qppd/smart-collar/README.md

# SmartCollar

**Offline GPS and LoRa-Based Smart Collar System for Carabao Location Monitoring and Tamper Detection**

A carabao wears a sealed, adjustable smart collar that acquires its GPS position and streams it over a LoRa radio link to a farm base station — **the collar itself needs no internet, no cellular signal, no subscriptions**. The base station checks every position against a geofence, watches for collar tampering and 24-hour immobility, and sounds a siren alarm on any abnormal condition. Farmers monitor locations and configure geofences from an **offline app installed on their phone**, connected to the base station over Bluetooth LE.

> Offline-first by design: positioning (GPS), collar communication (LoRa), and the farmer's app (Bluetooth LE + offline map data) never need the internet. The only time the project touches the internet is a **one-time provisioning step** — downloading the app bundle, MapLibre, and OpenStreetMap map data before deployment.

---

## Table of Contents

- [About](#about)
- [Main System](#main-system)
- [How It Works](#how-it-works)
- [Features & Alarm Conditions](#features--alarm-conditions)
- [System Architecture](#system-architecture)
- [Hardware](#hardware)
- [Design Priorities](#design-priorities)
- [Repository Structure](#repository-structure)
- [Build Guide](#build-guide)
- [Documentation Index](#documentation-index)
- [Power Strategy](#power-strategy)
- [Roadmap](#roadmap)
- [Team](#team)
- [Acknowledgment](#acknowledgment)

## About

Carabao theft, straying, and unmonitored sickness are real losses for smallholder farms — and rural grazing land usually has **no internet or cellular coverage**, which rules out commercial GSM/GPS trackers. SmartCollar is built for that reality: positioning comes from GPS satellites, communication travels over LoRa radio (kilometer-scale range, very low power), and all alarm logic runs locally at the base station. The whole system works even when the farm is completely offline.

The collar is worn by the animal full-time, so the **mechanical design is as critical as the electronics**: the collar is exposed to water (carabaos wallow and swim), mud, impact, pulling, and constant movement. Every design decision in this repo reflects that.

## Main System

| Component | Location | Role |
|---|---|---|
| **Smart Collar** | Worn by the carabao | GPS positioning, LoRa uplink, tamper detection, battery telemetry (discrete ESP32 build) |
| **Base Station** | Fixed, powered point at the farm | Receives LoRa data, evaluates alarm rules, drives the siren; pairs to the app over Bluetooth LE |
| **Offline Mobile/Desktop App** | Farmer's device | Location & status dashboard, geofence configuration |
| **Siren Alarm** | At the base station | Loud audible alert on any detected abnormal condition |

## How It Works

```mermaid
flowchart LR
    CAR["Carabao"] --> COLLAR["Smart Collar"]
    COLLAR -- "GPS + LoRa" --> BASE["Base Station"]
    BASE --> OUT["Siren + Offline App"]
```

1. The collar wakes on a duty cycle, gets a GPS fix, checks its tamper loop, and sends one compact LoRa packet (position, battery, tamper state, movement activity).
2. The base station receives the packet and evaluates three alarm rules:
   - **Geofence** — is the position inside the allowed polygon?
   - **Tamper** — strap cut, buckle opened, or loop bypassed?
   - **No movement for 24 hours** — possible downed or sick animal.
3. On any abnormal condition, the base station **fires the siren** and pushes an alert to the app.
4. The farmer opens the app on their phone (paired directly to the base station over Bluetooth LE, or USB on a laptop) to see live locations, history, status, and to **draw or edit the geofence**, which is pushed down to the collars.
5. The app renders the map from OpenStreetMap data pre-downloaded onto the phone (MapLibre, one-time provisioning) — no internet is needed at the farm, and an animal outside the geofence stays visible on the map as far as the collar can still report.

## Features & Alarm Conditions

The system raises an alarm when:

| # | Condition | What it means |
|---|---|---|
| 1 | **Geofence breach** | The carabao left the allowed grazing area |
| 2 | **Collar tamper** | Strap cut, buckle opened/removed, or tamper circuit bypass attempt |
| 3 | **No movement for 24 hours** | Abnormal condition — animal may be downed, trapped, or sick; needs physical checking |

Additional capabilities:

- Offline-first operation — GPS + LoRa + Bluetooth LE; no internet needed at the collar, base, or app
- Live location and history trail per collar, on an offline map in the app (OpenStreetMap + MapLibre, one-time provisioning)
- Geofence drawing/editing from the app, pushed to collars via the base station
- Battery level telemetry with low-battery warning
- Adjustable collar (fits different animals) **without** sacrificing tamper detection
- **Maintenance mode toggle** in the app — deliberate collar work (battery swap, strap adjustment) without triggering the siren; auto-expires so it can never silently mute the farm

## System Architecture

```mermaid
flowchart TB
    GPS["GPS satellites"] --> COLLAR["SMART COLLAR (on carabao)\nESP32 DevKit 38-pin + NEO-M8N GPS + SX1276 (915 MHz)\ntamper loop · MPU6050 · 18650"]
    LOOP["Tamper loop (wire rope)"] --> COLLAR
    COLLAR <-. "LoRa 915 MHz · offline radio link" .-> BASE["BASE STATION\nESP32 DevKit + SX1276 · alarm rules engine\ngeofence / tamper / 24 h no-move\nsiren driver · local app server"]
    BASE -- "relay" --> SIREN["SIREN ALARM<br/>12 V, loud"]
    BASE <-. "Bluetooth LE / USB — offline" .-> APP["OFFLINE APP (PWA)<br/>mobile / desktop<br/>MapLibre + offline OSM data<br/>map + geofence editor"]
```
Details: [docs/BLOCK-DIAGRAM.md](docs/BLOCK-DIAGRAM.md) · [docs/SYSTEM-ARCHITECTURE.md](docs/SYSTEM-ARCHITECTURE.md) · [docs/FLOWCHART.md](docs/FLOWCHART.md) · [docs/STACK.md](docs/STACK.md)

## Hardware

Core components (full list with indicative prices: **[docs/BOM.md](docs/BOM.md)**):

| Component | Role |
|---|---|
| ESP32 DevKit 38-pin + NEO-M8N GPS + SX1276 LoRa | Collar core — discrete ESP32 board with external GPS and LoRa modules (replaces integrated T-Beam) |
| 18650 Li-ion cell + holder | Collar power (Phase 1) — PMU-protected, charged off-animal in a smart charger |
| Conductive tamper loop (stainless wire rope) with buckle break-away link | Tamper detection on the adjustable strap |
| IP67 enclosure + PG7 glands + Suxun T7000 silicone sealant | Waterproof housing (carabaos wallow in water/mud) |
| Flexible whip antenna (915 MHz) | LoRa uplink, bulkhead-mounted, strain-relieved |
| MPU6050 accelerometer (GY-521) | Movement activity for the 24-hour no-movement rule |
| ESP32 DevKit + SX1276 LoRa module | Base station receiver |
| 12V waterproof siren + relay/MOSFET | Audible alarm at the base station |
| 2–3× 5 V 0.3 W solar panels (parallel) + CN3065 charge module | Phase 2 solar upgrade — farm-recommended |

## Design Priorities

The current design focus, in order of difficulty — each has a dedicated document:

| Priority | Document | Summary |
|---|---|---|
| Adjustable collar + reliable tamper circuit | [TAMPER.md](docs/TAMPER.md) | A continuous conductive loop across the **adjustable** portion — detects cut, buckle open, and bypass |
| Waterproof enclosure | [ENCLOSURE.md](docs/ENCLOSURE.md) | Sealed against wallowing/submersion, impact-resistant, protects electronics |
| Antenna strategy | [ENCLOSURE.md](docs/ENCLOSURE.md) | External antenna vs. sealed performance — must not degrade LoRa/GPS |
| Battery management | [POWER.md](docs/POWER.md) | Duty-cycled operation for weeks per charge |
| Solar-ready mechanical design | [ENCLOSURE.md](docs/ENCLOSURE.md) + [POWER.md](docs/POWER.md) | Farm recommends solar collars (video in `references/`); enclosure is solar-ready from day one — 2–3× 0.3 W panels on the lid |
| Physical form factor | [ENCLOSURE.md](docs/ENCLOSURE.md) | Based on the farm's recommendation and sample collar |

> **Key point:** this is not just a software/electronics project. The **mechanical design of the collar itself is critical** — it is exposed to water, mud, impact, pulling, and constant movement for its entire service life.

## Repository Structure

```
smartcollar/
├── README.md               ← you are here
├── docs/
│   ├── BOM.md              ← parts list with indicative prices
│   ├── WIRING.md           ← circuit diagram + full netlist (collar & base)
│   ├── HARDWARE.md         ← collar electronics, wiring, assembly
│   ├── TAMPER.md           ← tamper loop design on the adjustable collar
│   ├── ENCLOSURE.md        ← waterproofing, mechanical, antenna, solar-ready design
│   ├── POWER.md            ← battery management + solar roadmap
│   ├── FIRMWARE.md         ← collar & base station firmware, LoRa protocol
│   ├── BASE-STATION.md     ← receiver, siren, coverage planning
│   ├── MAP-PACK.md         ← one-time offline map provisioning guide
│   ├── APP.md              ← offline dashboard, geofence editor
│   ├── TESTING.md          ← test & evaluation protocol
│   ├── STACK.md            ← full technology stack reference
│   ├── BLOCK-DIAGRAM.md    ← hardware blocks & signal chains
│   ├── FLOWCHART.md        ← runtime decision logic
│   ├── SYSTEM-ARCHITECTURE.md ← layers, interfaces, failure modes
│   └── NTC-COMPLIANCE.md   ← PH radio regulations & certification guidance
├── model/
│   └── SmartCollar.f3z  ← Fusion 360 3D model
├── wiring/
│   ├── SmartCollar.png     ← full wiring diagram (Cirkit Designer)
│   └── SmartCollar.ckt     ← editable Cirkit Designer project
└── references/             ← datasheets, farm video, related material
```

## Build Guide

The build is organized into stages. Follow in order:

| Step | Guide | What you'll do |
|---:|---|---|
| 1 | [docs/BOM.md](docs/BOM.md) | Order all parts |
| 2 | [docs/WIRING.md](docs/WIRING.md) | Study the circuit diagram + netlist (collar & base) |
|| 3 | [docs/HARDWARE.md](docs/HARDWARE.md) | Assemble collar electronics, verify ESP32 GPS + LoRa |
| 4 | [docs/TAMPER.md](docs/TAMPER.md) | Build and validate the adjustable tamper loop |
| 5 | [docs/ENCLOSURE.md](docs/ENCLOSURE.md) | Seal the enclosure, mount antenna, solar-ready lid |
| 6 | [docs/POWER.md](docs/POWER.md) | Configure duty cycling, measure battery endurance |
| 7 | [docs/FIRMWARE.md](docs/FIRMWARE.md) | Flash collar + base station, tune the LoRa protocol |
| 8 | [docs/BASE-STATION.md](docs/BASE-STATION.md) | Install receiver, siren, coverage survey |
| 9 | [docs/MAP-PACK.md](docs/MAP-PACK.md) | Build the offline Map Pack (MapLibre + OpenStreetMap) |
| 10 | [docs/APP.md](docs/APP.md) | Set up the offline dashboard + geofence editor |
| 11 | [docs/TESTING.md](docs/TESTING.md) | Run the full verification protocol |

## Documentation Index

| Document | Contents |
|---|---|
| [BOM.md](docs/BOM.md) | Collar + base station parts, specs, indicative PH prices |
| [WIRING.md](docs/WIRING.md) | Circuit diagram, full netlist, power rails, build-order notes |
|| [HARDWARE.md](docs/HARDWARE.md) | Collar electronics, wiring tables, accelerometer, assembly (discrete ESP32 build) |
| [TAMPER.md](docs/TAMPER.md) | Tamper loop options, supervised-loop circuit, bypass resistance, alarm codes |
| [ENCLOSURE.md](docs/ENCLOSURE.md) | IP-rating targets, sealing strategy, antenna mounting, solar-ready design, mechanical tests |
| [POWER.md](docs/POWER.md) | Power budget, duty cycle, charging rotation, solar sizing |
| [FIRMWARE.md](docs/FIRMWARE.md) | State machines, LoRa packet format, geofence & alarm logic |
| [BASE-STATION.md](docs/BASE-STATION.md) | Hardware, antenna placement, siren wiring, range planning |
| [MAP-PACK.md](docs/MAP-PACK.md) | One-time provisioning: MapLibre + OSM extract for the offline map |
| [APP.md](docs/APP.md) | Offline maps, dashboard, geofence editor, tech options |
| [TESTING.md](docs/TESTING.md) | Range, GPS, tamper, immersion, endurance, mechanical tests |
| [STACK.md](docs/STACK.md) | Full technology stack — collar, base station, app, radio link |
| [BLOCK-DIAGRAM.md](docs/BLOCK-DIAGRAM.md) | Hardware blocks, tamper sense circuit, signal chains |
| [FLOWCHART.md](docs/FLOWCHART.md) | Runtime logic — collar duty cycle, base alarm pipeline, app session |
| [SYSTEM-ARCHITECTURE.md](docs/SYSTEM-ARCHITECTURE.md) | Layers, component responsibilities, interfaces, failure modes |

## Power Strategy

- **Phase 1:** battery-powered collars — 18650 Li-ion, aggressive duty cycling, ~2 weeks per charge with swap rotation.
- **Phase 2:** solar lid-swap upgrade — enclosure solar-ready from day one. Full details: [POWER.md](docs/POWER.md).

## Roadmap

- [x] Circuit diagram + netlist drawn (Cirkit Designer — [WIRING.md](docs/WIRING.md))
- [ ] Parts ordered & verified (BOM)
|- [ ] Discrete ESP32 collar bench test: GPS fix + LoRa link
- [ ] Tamper loop working on an adjustable strap
- [ ] Enclosure passes immersion test
- [ ] Full collar worn-test on animal (comfort, anti-rotation, wallow test)
- [ ] Base station + siren installed at farm
- [ ] Offline app with geofence editor
- [ ] Field trial: multi-day herd monitoring
- [ ] Solar lid prototype (Phase 2)

## Team

`[Course / Program]` · `[University]`

- `[Student Name]`
- `[Student Name]`
- `[Student Name]`

Adviser: `[Adviser Name]`

## Acknowledgment

Pilot client: **[Farm name]** — who recommended the solar collar direction and provided a sample collar video (kept in `references/`).

| *This project is an academic prototype. The full manuscript is available from the team on request.*

---

## Hardware Migration Note (2026-11)

The original design used a LilyGO T-Beam v2.x integrated board. For improved sourcing reliability and modularity in the Philippines, the project has been migrated to a **discrete ESP32 DevKit 38-pin** build with separate NEO-M8N GPS and SX1276 LoRa modules.

All original objectives, features, and functionality are preserved. The migration details are documented inline in each guide: [HARDWARE.md](docs/HARDWARE.md) for pin maps and power architecture, [BOM.md](docs/BOM.md) for sourcing, [NTC-COMPLIANCE.md](docs/NTC-COMPLIANCE.md) for regulatory guidance.
