qppd/smart-collar/references/README.md

# References

Source materials for the SmartCollar project.

| File | What it is |
|---|---|
| `farm-solar-collar-sample.mp4` *(to be added)* | Video sent by the farm — sample collar with solar panel. Basis of the solar-ready enclosure requirement and Phase-2 roadmap ([POWER.md](../docs/POWER.md), [ENCLOSURE.md](../docs/ENCLOSURE.md)). Save the original file here. |
| `tbeam-v2.x-datasheet.pdf` *(to be added)* | LilyGO T-Beam v2.x specifications (ESP32, NEO-M8N, SX1278, AXP2101 PMU). |
| `sx1278-datasheet.pdf` *(to be added)* | Semtech SX1278 LoRa transceiver datasheet (the SX1276/77/78 family datasheet) — radio settings, sleep currents, link budget. |
| `mpu6050-datasheet.pdf` *(to be added)* | InvenSense MPU6050 — motion-detect (MOT_THR/MOT_DUR) + accel-only cycle mode configuration for the 24-h rule. |

## To Collect

- [ ] Farm's sample-collar video → save as `farm-solar-collar-sample.mp4`
- [ ] Datasheets above (download PDFs into this folder)
- [ ] Photos of the farm site (site survey, mast candidates)
- [ ] PH frequency-regulation notes for 433/915 MHz ISM use (NTC)
- [ ] Commercial GPS tracker specs for comparison table (capstone Related Works)
