qppd/smart-collar/docs/SYSTEM-ARCHITECTURE.md

# System Architecture

Layers, boundaries, and interfaces — how SmartCollar is organized as a system, from strap to siren. Diagrams are **Mermaid** and render in any Mermaid-compatible viewer.

---

## 1. Layered View

```mermaid
flowchart TB
    L5["L5 · PRESENTATION<br/>PWA (MapLibre + offline OSM data)<br/>map · alarm feed · geofence editor · maintenance toggle"]
    L4["L4 · APPLICATION (base)<br/>BLE GATT server + USB serial · config endpoints<br/>siren driver · ACK/re-arm handling<br/>maintenance-mode gate"]
    L3["L3 · RULES &amp; DATA (base)<br/>alarm engine: geofence / tamper / 24 h no-move<br/>ring buffer + LittleFS history (CSV/JSON)"]
    L2["L2 · EDGE DEVICES<br/>collar firmware: duty-cycle state machine, GPS,<br/>tamper sense, activity counter, LoRa MAC<br/>base firmware: RX, dedupe, rules feed"]
    L1["L1 · SENSING &amp; PHYSICS<br/>NEO-M8N GPS · supervised tamper loop · MPU6050<br/>SX1276 LoRa radios (915 MHz) · 18650 + AP2112 LDO + GPIO-gated rails"]
    L1 -- "GPIO electrical" --> L2
    L2 -- "LoRa 915 MHz radio" --> L3
    L3 --- L4
    L4 -- "Bluetooth LE / USB (offline)" --> L5
```

**Key boundary decisions:**

- **Collar senses, base decides.** The collar's job is a compact, honest packet: position, battery, tamper flags, activity. All alarm logic — geofence, tamper verdict, 24-hour immobility — runs at the base, where power and compute are unlimited. Collars stay dumb, cheap, and low-power.
- **Raw LoRa, not LoRaWAN.** There is no offline gateway/network-server infrastructure, and we control both ends. A simple ACK/retry MAC with jittered intervals replaces it entirely.
- **The base *is* the farm's local server.** App data, config, history, alarms — all served from one ESP32 over **Bluetooth LE** or USB; the map stack (MapLibre + OpenStreetMap data) lives in each phone from one-time provisioning. The farmer's phone never needs a network beyond the farm.
- **The app talks to the base over Bluetooth LE, never the internet.** The phone pairs to the base's GATT server (notify + write characteristics); map data comes from the phone's one-time OSM/MapLibre provisioning. The collar stays offline by design — LoRa is its only radio. The core loop (LoRa → rules → siren → local app) has no cloud dependency anywhere.
- **Collar evaluation is early-warning only.** The collar can hold the geofence polygon and flag "outside" on-carpet, but the base's point-in-polygon verdict is authoritative.

## 2. Component Responsibilities

| Component | Owns | Never does |
|---|---|---|
| NEO-M8N GPS | position fixes (warm-start ephemeris in RTC RAM) | alarm decisions |
| Supervised tamper loop | resistance signature of the intact collar (baseline R₀, recorded per collar) | power switching |
| MPU6050 | motion activity + motion-detect interrupt | position (GPS's job) |
| Collar ESP32 | duty cycle, tamper ADC, packet build/TX, latch handling | point-in-polygon verdicts (early flag only) |
| Base ESP32 | RX/dedupe, alarm rules, siren patterns, app server, history | GPS fixes |
| LittleFS history | durable per-collar log (position, flags, loop R, batt) | alarm logic |
| Siren | audible alert, patterned per alarm type | logic |
| PWA | map, alarm feed, ACK, geofence drawing | rule evaluation (base's job) |

## 3. Interfaces (the contract set)

| # | Interface | Protocol | Contract |
|---|---|---|---|
| I1 | GPS → collar UART | NMEA (TinyGPSPlus) | fix within 90 s or STALE reuse |
| I2 | Tamper loop → GPIO36 | analog ADC via 10 kΩ bias, GPIO25 excite | bands relative to baseline R₀; outside = latched alarm |
| I3 | MPU6050 → collar I²C | I²C poll each wake (21/22) | latched motion flag → activity counter; never a GPS/TX cycle |
| I4 | Collar → base (SX1276 → Ra-02 SX1276) | raw LoRa 915 MHz, SF7–SF9, sync 0x2B, ≤23 B binary | position, battery, tamper flags, activity, SEQ |
| I5 | Base → collar downlink | LoRa at wake windows / daily sync | geofence polygon, interval change, ACK, clear-tamper-latch |
| I6 | Base ↔ phone | Bluetooth LE GATT (Web Bluetooth): notify + write | live positions/alarms (MTU-chunked JSON); commands: geofence, ACK, interval, MAINT_ON/OFF |
| I7 | Base ↔ USB device | Web Serial (Chrome) | most-reliable zero-WiFi channel |
| I8 | Base → siren | GPIO17 → relay IN1 → 12 V | patterned drive per alarm type (GPIO23 reserved for Ra-02 SPI MOSI) |
| I9 | Phone → base clock sync | BLE `TIME_SET {epoch}` on app connect | wall-clock timestamps; `unsynced` flag after an offline reboot — no alarm rule depends on wall time |
| I10 | Maintenance toggle → rules engine | BLE `MAINT_ON {min}` / `MAINT_OFF` | gates siren/alarm path only; detected events logged as `suppressed`; auto-expires |

## 4. Network Topology

```mermaid
flowchart LR
    C1["Collar #1"] <-. "LoRa 915 MHz<br/>jittered intervals" .-> BASE["BASE STATION<br/>mast antenna 3–5 m, grounded<br/>phone-set clock · BLE server"]
    C2["Collar #2"] <-.-> BASE
    CN["Collar #N"] <-.-> BASE
    BASE -- "Bluetooth LE GATT<br/>notify + write" --> PHONE["Farmer phone<br/>PWA installed to home screen"]
    BASE -- "USB (serial)" --> LAPTOP["Laptop / desktop"]
    BASE -- "relay" --> SIREN["12 V siren"]
```

- **One star topology:** all collars → one base; nothing meshed, nothing routed. A dead collar can't take others down.
- **Frequency plan:** 915 MHz ISM preferred in PH; collar and base bands **must match**.
- **Range reality:** 2–8 km open/rolling terrain, 300 m–2 km dense trees (SF7–SF9 choice per site) — the site survey decides placement, not hope.
- **No SIM, no WiFi anywhere:** the collar's only external dependency is GPS satellites; the only farm infrastructure link is Bluetooth LE to the farmer's phone. The internet appears exactly once — downloading MapLibre + OpenStreetMap data during provisioning.

## 5. Failure Modes & Degradation

| Failure | Immediate effect | System behavior |
|---|---|---|
| GPS no-fix (canopy, rain) | position STALE | reuse last fix, flag it; alarm rules keep running on stale data |
| LoRa packet lost | missed position | SEQ dedupe on RX; emergency packets retry 3× @ 30 s; buffer at next wake |
| Collar battery low | shorter radio life | BAT_PERCENT telemetry → app alert < 20%; swap-and-charge rotation |
| Base brownout | rules pause | no UPS by design — history in LittleFS survives; watchdog self-heals; clock re-syncs from the phone on next connect; collars buffer-and-retry until power returns |
| Lightning storm | antenna risk | disconnect procedure; collars buffer-and-retry — an offline hour is fine |
| Tamper false positives (corrosion) | spurious alarms | 8-sample ADC averaging, window margins, debounce; app maintenance mode = service window |
| Farmer misses alarm | siren keeps sounding | re-arm logic: ACK silences siren but event persists until condition clears (e.g., 2 packets back inside fence) |
| App phone offline | no dashboard | cached PWA opens offline; history catches up over BLE (delta-sync) on reconnect |
| Phone out of BLE range | no live dashboard | the farm doesn't stop — LoRa RX, rules, siren, and history all run headless; the app catches up over BLE (delta-sync) on reconnect |
| Maintenance toggle left ON | alarms muted | **auto-expiry** (default 30 min, max 2 h) re-enables the siren; every ON/OFF/expiry is timestamped |

**Design principle:** every abnormal condition is *latched* — a transient (brief loop open, one lost packet) can never silently clear itself without the base seeing it.

## 6. Deployment Topology (prototype → production path)

```mermaid
flowchart LR
    P1["Phase 1 · Prototype<br/>battery collars (18650)<br/>swap-and-charge rotation<br/>~2 weeks per charge"] --> P2["Phase 2 · Solar lid<br/>5 V panel + Li charge module<br/>lid swap — no redesign<br/>(enclosure solar-ready from day 1)"]
```

The architecture doesn't change between phases — only the collar's power source (and the enclosure lid). Base, radio, rules, and app are identical.

---

Interfaces in detail: [FIRMWARE.md](FIRMWARE.md) §packet format · Alarm rules: [BASE-STATION.md](BASE-STATION.md) · Signals: [BLOCK-DIAGRAM.md](BLOCK-DIAGRAM.md) · Logic: [FLOWCHART.md](FLOWCHART.md)
