qppd/smart-collar/docs/POWER.md

# Power Strategy — Battery Now, Solar-Ready

Two-phase strategy, driven by the farm's own recommendation:

- **Phase 1 (prototype, this repo):** battery-powered — 18650 Li-ion, aggressive duty cycling, swap-and-charge rotation.
- **Phase 2 (upgrade):** solar trickle charging — small panel on a swappable lid. **The Phase-1 enclosure and electrical layout are already solar-ready** (see [ENCLOSURE.md](ENCLOSURE.md)) so the upgrade is a lid swap, not a redesign.

---

## Phase 1 — Battery Budget (per collar)

Assume an **ESP32 DevKit 38-pin** + **NEO-M8N GPS** + **SX1278-class LoRa (433 MHz)** on one 18650 (3,500 mAh, ~11.5 Wh). No integrated PMU — rail shutdown via GPIO-gated N-channel MOSFETs.

### Component current draw (order-of-magnitude, datasheet-typical)

| State | Subsystems on | Current | Duration per cycle |
|---|---|---:|---|
| GPS fix acquisition | ESP32 active + GPS module | ~90 mA | 30–60 s (TTFF from cold; warm fix ~5–15 s) |
| LoRa TX (1 packet, SF7–SF9) | ESP32 active + radio | ~120 mA | 0.1–0.3 s |
| Accelerometer watch (movement rule) | MPU6050 in accel-only cycle mode | ~10–70 µA | continuous while sleeping |
| Deep sleep between cycles | ESP32 deep sleep + RTC + MPULDO off | **~0.5–2 mA\*** | rest of interval |

\* With GPIO-gated rail cutoff (GPS/LoRa rails off), ESP32 deep-sleep base is ~10 mA but only RTC runs (~0.1 mA). With GPS and LoRa modules powered down via MOSFETs, total system sleep approaches **~0.5–1.5 mA**. Measure real current early.

### Duty cycle scenarios (10-min reporting interval, 1-min GPS window)

Average current ≈ (GPS 60 s × 90 mA + TX 0.3 s × 120 mA + RX window 3 s × 90 mA + sleep 536.7 s × 1.5 mA) / 600 s ≈ **~10.95 mA**

| Reporting interval | Est. average current | Runtime on 3,500 mAh |
|---|---:|---|
| 5 min | ~19.5 mA | ~7 days |
| **10 min (chosen)** | ~11.0 mA | **~13 days** |
| 15 min | ~7.9 mA | ~18 days |
| 30 min | ~4.8 mA | ~30 days |

> **Worst-case note:** the budget above assumes a **60 s GPS fix per cycle** (warm start) plus a 3 s RX window after every TX (see [FIRMWARE.md](FIRMWARE.md) — RX windows). If cold fixes run to the firmware's `GPS_TIMEOUT` of 90 s (see [FIRMWARE.md](FIRMWARE.md)) every cycle, average current rises to **~15.2 mA → ~10 days** on 3,500 mAh. `moved=false` motion-gating and warm-start ephemeris exist precisely to keep real-world duty below this line; measure actual fix duration during bench bring-up.

**Design target: ≥ 2 weeks per charge at a 10-minute interval**, with a swap rotation (one charged spare per collar) so animals are never un-collared. The interval is configurable from the app per collar — racehorses get 5 min, calm herds 30 min.

> GPS duty-cycling dominates the budget. Two easy wins: (1) **warm starts** — keep GPS ephemeris in RAM (fix in 5–15 s instead of 30–60 s); (2) **motion-gated fixes** — if the accelerometer says the animal hasn't moved since the last fix, skip GPS and re-send the last known position (movement ≤ threshold), saving up to ~80% of GPS energy.

### The 24-hour no-movement rule and power

The accelerometer must run *while the collar sleeps* — use the **MPU6050 motion-detect interrupt**: accel-only cycle mode (register PWR_MGMT_1 = accel on, gyro + temp off; LP_WAKE_CTRL rate 5 Hz) detects activity at ~10–70 µA and wakes the ESP32 only on movement (MOT_THR / MOT_DUR configured for head-shake / grazing-scale motion, not vibration noise).

**Critical power rule:** motion is **polled, never an interrupt** — each 10-min wake reads the MPU6050's latched motion flag (INT_STATUS), increments the activity counter if set, and goes straight back to sleep. Motion **never** triggers a full GPS/TX cycle (an actively grazing carabao would destroy the budget). Full cycles run on the RTC timer only. If the counter hasn't incremented in 24 h, the next scheduled LoRa packet is flagged `NO_MOVEMENT` → base station raises the alarm.

**GY-521 module caution (sleeper current):** the common purple GY-521 breakout has a power LED (~1–2 mA) and an LDO (~1 mA quiescent) that never sleep — 2–3 mA that would dominate the whole sleep budget. Fix at assembly: **strip the power LED** and **bypass the LDO** (feed 3V3 straight to VCC), or budget for it. Bare-die MPU6050 on a custom board avoids this entirely. Verify with the µA meter — same rule as the discrete build rails.

### Measured-first policy

All figures above are estimates. In Week 1, measure for real (see [TESTING.md](TESTING.md)):

1. Actual deep-sleep current of the ESP32 build (USB power meter + inline ammeter; expect surprises)
2. Actual TTFF warm vs cold at the farm (open sky)
3. Actual energy per GPS+TX cycle

Then finalize the reporting interval that gives ≥ 2 weeks.

## Battery Care & Safety

- **Protection story:** the sourced LiitoKala cells are an unprotected 10 A high-drain class (protected-cell listings didn't qualify — see [BOM.md](BOM.md)). The TP4056 charging module provides over-voltage/over-current cut-off during USB charging; all main charging happens off-animal in the smart charger (below), never on-animal, never unattended.
- Low-battery alarm at 20% (app notification), critical at 10% (collar reduces interval to conserve, still must alarm).
- Charge at ≤ 0.5 C on the LiitoKala Lii-500 smart charger (4-slot, capacity-test mode — its test figure drives the cell-retirement log); rotate cells FIFO; retire cells at < 80% rated capacity (log per cell ID in the app maintenance record).
- Temperature: Li-ion must never charge below 0 °C or above 45 °C — carabao collar interior can exceed this in direct sun; the charger must be temperature-compensated or charging happens indoors during the swap (Phase 1: **charging happens off-animal, indoors** — simplest and safest).
- Cell holder with tabs soldered (not spring contacts if vibration is severe — springs walk off; crimped tab + holder hybrid chosen).

## Phase 2 — Solar Sizing

Sizing logic (10-min interval, ~10.95 mA avg @ 3.7 V ≈ **~41 mW** continuous — includes the 3 s RX window after every TX):

| Requirement | Value |
|---|---:|
| Daily energy need | ~0.97 Wh |
| PH sun (conservative effective) | 3 h/day full-sun equivalent |
| Array needed (with 70% path efficiency incl. shading/dirt/charge loss) | ~0.62 W STC → **2–3× 5 V 0.3 W panels** |

**Panel choice: sourced 5 V 0.3 W epoxy panels (Lazada, ~₱93 each — see [BOM.md](BOM.md)), all the same voltage class, wired in parallel.** Physics check: 2 × 0.3 W STC × 3 h × 70% ≈ **1.26 Wh/day**, already above the need — see the array table below.

| Array (parallel) | STC power | Harvest/day (3 h, 70%) | Coverage of 0.97 Wh |
|---|---:|---:|---|
| 1× 0.3 W panel | 0.3 W | ~0.63 Wh | ~65% — roughly triples the swap interval |
| 2× 0.3 W panels | 0.6 W | ~1.26 Wh | **~130% — break-even at 10-min interval** |
| 3× 0.3 W panels | 0.9 W | ~1.89 Wh | ~195% — headroom for rainy days & motion-gated skips |

At a 30-min reporting interval the need drops to ~0.43 Wh/day → **one panel breaks even** there. **Sourced panels are 5 V 0.3 W epoxy units (~₱93 each, see [BOM.md](BOM.md))** — the exact 20×20 mm / 0.04–0.06 W class isn't listed on Lazada PH, so **2–3 sourced panels replace the originally sketched 6–8× 2×2 cm array**. Target stays: battery as buffer, solar as trickle — the collar rides through nights and rainy days on the 18650, and the array tops it up during grazing. Rainy-season expectations: solar extends the swap interval from 2 weeks toward 1–2 months rather than making it infinite.

### Wiring (validated against CN3065 + ESP32 build)

Chain: **array → per-panel Schottky → potted junction → PG7 gland → sealed JST 2-pin → CN3065 VIN; CN3065 BAT → 18650 tabs (in parallel with the ESP32 battery connection)**. The ESP32 draws from the cell directly via the AP2112 LDO; the CN3065 charges the cell independently (USB charger stays for bench charging).

1. **Parallel only, never series.** Series stacking pushes input past the CN3065's 6.5 V absolute maximum (operating range 4.4–6.0 V). Parallel adds current only — exactly what a trickle array wants.
2. **One Schottky diode (1N5819/SS14) in series with each panel.** Without it, a shaded panel *sinks* current from the lit ones — the animal's head shadow is the common case, not an edge case. Diodes cost ~₱2 each and cut shading loss to roughly the shaded fraction.
3. **Voltage class:** prefer 5 V-class panels (Voc ~6.0–6.3 V); 5.5 V-class (Voc 6.6 V) rides close to the CN3065's 6.5 V abs-max on a cold bright morning. In PH heat the real Voc sits well under the STC figure (−0.33 %/°C), so both classes work — but verify with a multimeter at build time (checklist below).
4. **Charge rate is inherently safe.** ~80–160 mA from the array into a 3,500 mAh cell = **0.02–0.05 C trickle** — thermally gentle even when the enclosure interior warms past ambient (Li-ion charge window 0–45 °C; PH never approaches 0 °C). The Phase-1 rule "0.5 C charging happens indoors" stays for USB smart-charger swaps.
5. **TS/TEMP pin grounded** (stock module default) — no NTC on tab-soldered 18650s; the low trickle rate is the safety margin instead.
6. **Night drain:** the CN3065 sleeps at < 3 µA with no input (datasheet) — negligible against the 1.5 mA deep-sleep budget.
7. **Telemetry unaffected:** battery percentage comes from ADC reading (GPIO35) through a resistive divider — truthful with solar in parallel.
8. **Feed the cell, not the ESP32 USB/5V pin.** The CN3065 charges the cell directly; the ESP32 draws from the cell through the AP2112 LDO. This is why a solar charge module is required, not just a diode.

## Solar Roadmap Checklist

- [ ] Verify Phase-1 enclosure accepts the solar lid with no case redesign
- [ ] Measure each 0.3 W panel's Voc before wiring (must be ≤ 6.5 V class — 5 V-class preferred; identical voltage class across all panels)
- [ ] Bench-test CN3065 + 0.3 W panel array → 18650 charge profile in sun/window light
- [ ] Partial shading test (animal's head blocks half the panel) — charge current still positive?
- [ ] Lid gasket survives 50 lid-swaps (service simulation)
- [ ] 2-week field trial on one animal → log battery % vs sun exposure
