qppd/smart-collar/docs/FLOWCHART.md

# Flowchart

Runtime behavior, decision by decision — the logic view of SmartCollar, matching the actual firmware state machines in FIRMWARE.md. Diagrams are **Mermaid** and render in any Mermaid-compatible viewer.

---

## 1. Collar Main State Machine

One duty cycle, every `REPORT_INTERVAL` (default 10 min) — motion is **polled each wake and only counts activity, never triggers a full cycle** (see POWER.md):

```mermaid
flowchart TB
    | DEEP SLEEP<br/>GPS rail off · LoRa rail off · AXP rails down (GPIO-gated) · wake on RTC timer only · target < 2 mA whole-system (measure!) |
    SLEEP -- "every 10 min (RTC timer)" --> WAKE["Wake · poll MPU6050 motion flag<br/>(latched INT_STATUS since last wake)"]
    WAKE -- "flag set" --> COUNT["activity counter++"]
    COUNT --> TAMPER
    WAKE --> TAMPER["Measure tamper loop<br/>GPIO25 excite → GPIO36 ADC<br/>8-sample avg · 100 ms debounce<br/>band check vs R₀ ± 30%?"]
    TAMPER --> GFIX{"GPS fix<br/>≤ 90 s?<br/>(warm-start RTC RAM)"}
    GFIX -- "no fix" --> STALE["reuse last position<br/>flag STALE"]
    GFIX -- "fix" --> POS["fresh position"]
    STALE --> PKT
    POS --> PKT["Build LoRa packet ≤ 23 B<br/>position · battery · tamper flags · activity · SEQ"]
    PKT --> TX{"TX OK?<br/>retries 3×"}
    TX -- "no ACK" --> RETRY["retry @ 30 s spacing<br/>(emergency packets)"]
    RETRY --> LATCHQ
    TX -- "sent" --> RXW["RX window 3 s<br/>ACK · interval · geofence chunks"]
    RXW --> LATCHQ{"Latched<br/>tamper alarm?"}
    LATCHQ -- "yes" --> NOW["send high-priority packet NOW<br/>then every 1 min until base ACKs<br/>(a collar under attack must not go quiet)"]
    NOW --> BACK
    LATCHQ -- "no" --> BACK["Deep sleep"]
    RETRY -- "still failing" --> BACK
    TAMPER -- "brief glitch, re-closed →" --> SUSPECT["latch LOOP_SUSPECT warning<br/>(telemetry only — no siren)"]
    SUSPECT --> GFIX
    TAMPER -- "outside window, debounced →" --> LATCHEV["latch alarm flag<br/>subtype CUT / SHORT preserved"]
    LATCHEV --> GFIX
```

## 2. Base Station Alarm Pipeline

Every received packet walks the rules engine:

```mermaid
flowchart TB
    RX["LoRa RX interrupt"] --> VAL{"validate MAGIC<br/>+ SEQ dedupe?"}
    VAL -- "invalid / replay" --> DROP["drop (no duplicate alarms)"]
    VAL -- "valid" --> RING["store in ring buffer<br/>(last N positions per collar)"]
    RING --> RULES["evaluate alarm rules"]
    RULES --> GEOF{"GEOFENCE:<br/>point-in-polygon on<br/>latest position?"}
    RULES --> TAMP{"TAMPER:<br/>FLAGS bits from collar?"}
    RULES --> NOMOVE{"NO_MOVE:<br/>ACTIVITY below threshold<br/>continuously 24 h?"}
    RULES --> BATT{"BAT_PERCENT<br/>&lt; 20%?"}
    BATT -- "yes" --> APPLERT["app alert only<br/>(no siren)"]
    BATT -- "no" --> HIST
    GEOF -- "breach" --> MAINT{"maintenance mode ON?<br/>(auto-expires)"}
    TAMP -- "yes" --> MAINT
    NOMOVE -- "yes" --> MAINT
    MAINT -- "yes" --> SUPPRESS["log as `suppressed`<br/>no siren · no alarm feed<br/>(battery/silence alerts still pass)"]
    SUPPRESS --> HIST
    MAINT -- "no" --> ALARM["NEW alarm → siren ON<br/>pattern per type · app push queued"]
    ALARM --> ACKQ{"farmer ACK in app?"}
    ACKQ -- "yes" --> SIRENOFF["siren OFF · event archived<br/>re-arm when condition clears<br/>(e.g. 2 consecutive packets back inside fence)"]
    GEOF -- "inside" --> HIST
    TAMP -- "no" --> HIST
    NOMOVE -- "no" --> HIST
    HIST["append history<br/>LittleFS CSV/JSON per collar<br/>~100 KB / collar / month<br/>clock: phone-set via BLE (TIME_SET)<br/>unsynced flag after offline reboot"]
    HIST --> PUSH["BLE notify → app<br/>(live positions + alarms,<br/>MTU-chunked JSON)"]
    PUSH --> WDOGB["task watchdog feeds<br/>(LoRa RX + BLE server loops)"]
    SIRENOFF --> WDOGB
    APPLERT --> HIST
```

**Siren patterns:** geofence = 3 short / 2-min pause repeat · tamper = continuous · no-movement = 10 s every 5 min. Auto re-arm.

## 3. App Session (farmer)

```mermaid
flowchart LR
    CONN["pair Bluetooth LE<br/>SmartCollar-Base<br/>(or USB serial)"] --> OPEN["open PWA<br/>fully offline<br/>(home-screen install)"]
    OPEN --> MAP["map view — MapLibre<br/>offline OpenStreetMap data<br/>live positions + history trail<br/>markers stay visible past the geofence"]
    MAP --> ALARMS["alarm feed + banner<br/>on-device notification (persistent)"]
    ALARMS --> ACK["ACK an alarm<br/>→ siren silences, event archived"]
    MAP --> EDIT["geofence editor<br/>draw/edit polygon, ≤ 16 vertices/paddock"]
    EDIT --> PUSH["save → BLE write → base pushes polygon<br/>to collars at next wake window"]
    PUSH --> MAP
    OPEN --> MAINT["Maintenance mode toggle<br/>MAINT_ON {minutes} / MAINT_OFF<br/>auto-expires · every change logged"]
    MAINT --> MAP
```

## 4. Geofence Push-Down Path

```mermaid
flowchart LR
    DRAW["farmer draws polygon<br/>in app"] --> SAVE["save over BLE write<br/>to base station"]
    SAVE --> DAILY["base broadcasts<br/>daily timeslot sync"]
    DAILY --> WINDOW["collars align wake<br/>windows to the sync"]
    WINDOW --> DL["downlink at wake:<br/>geofence polygon · interval change ·<br/>ACK · clear-tamper-latch (service mode)"]
    DL --> EARLY["collar evaluates polygon on-collar<br/>for early warning (geofence early flag)"]
```

---

State machine source: [FIRMWARE.md](FIRMWARE.md) · alarm rules & hysteresis: [BASE-STATION.md](BASE-STATION.md) · Blocks & signals: [BLOCK-DIAGRAM.md](BLOCK-DIAGRAM.md) · Layers: [SYSTEM-ARCHITECTURE.md](SYSTEM-ARCHITECTURE.md)
