qppd/smart-collar/model/SmartCollar1.png

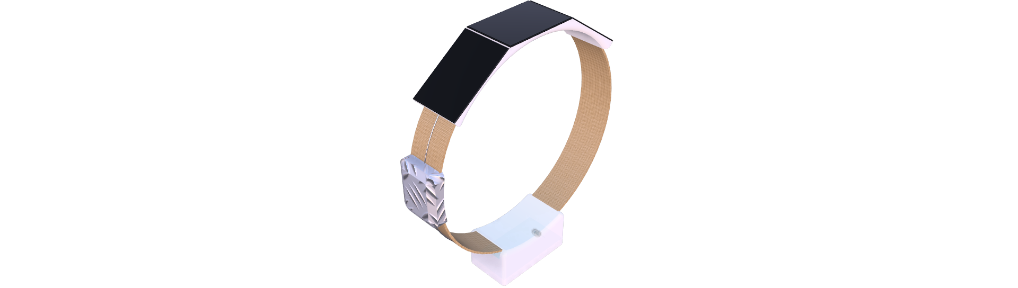
model/SmartCollar1.png
