qppd/smart-collar/model/SmartCollar2.png

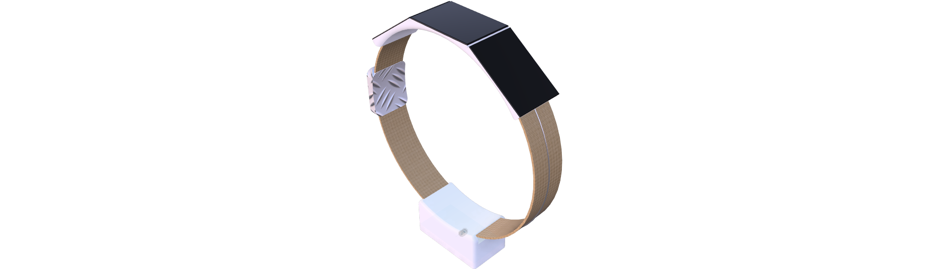
model/SmartCollar2.png
