qppd/smart-collar/model/SmartCollar3.png

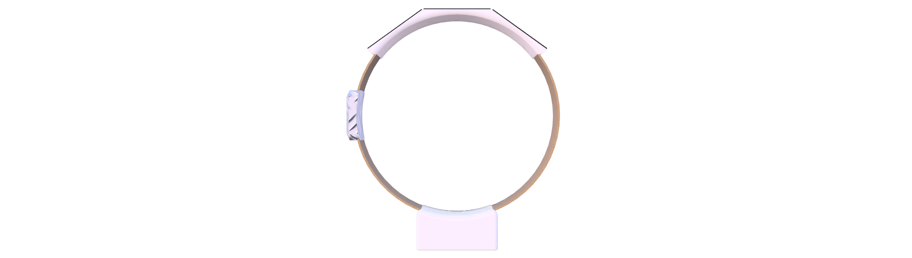
model/SmartCollar3.png
