qppd/smart-collar/model/SmartCollar4.png

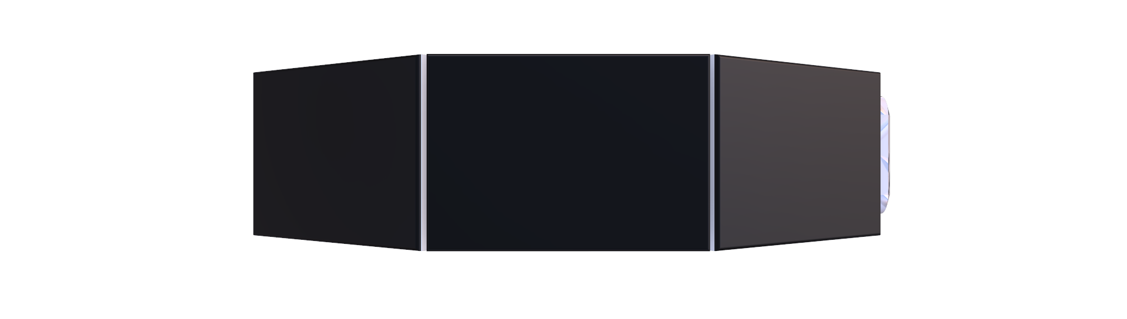
model/SmartCollar4.png
