qppd/smart-collar/model/SmartCollar6.png

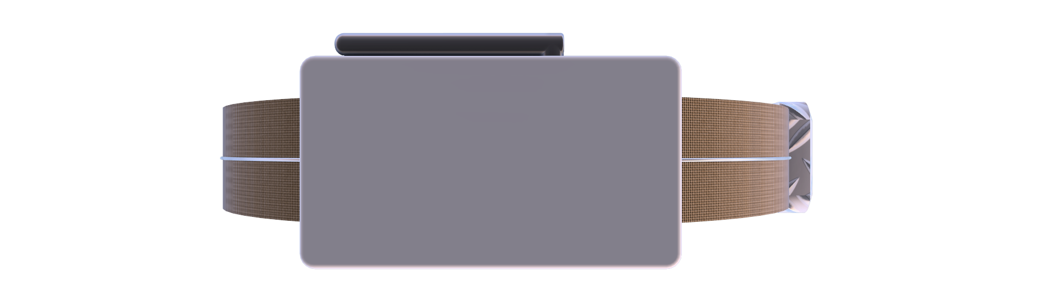
model/SmartCollar6.png
