qppd/smart-collar/model/SmartCollar7.png

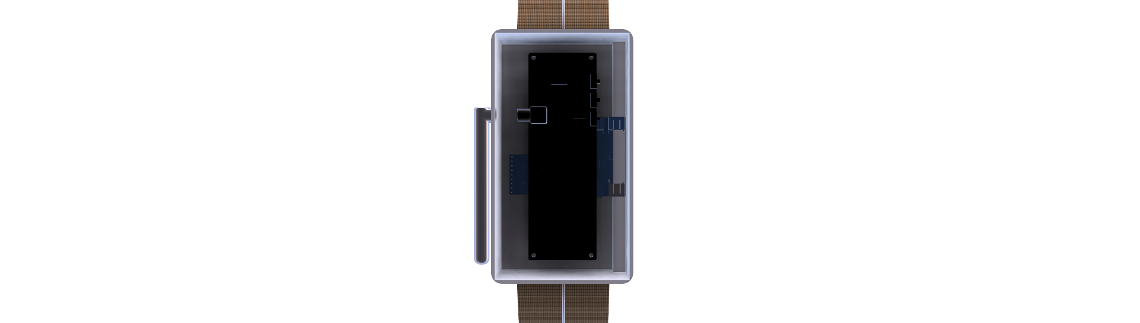
model/SmartCollar7.png
