qppd/smart-collar/model/SmartCollar8.png

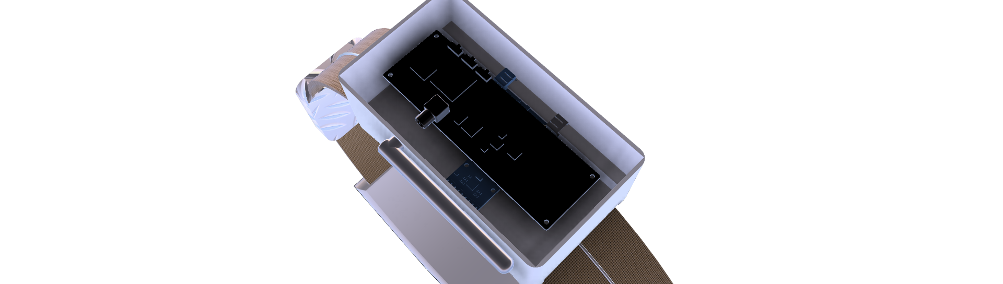
model/SmartCollar8.png
