qppd/smart-collar/model/SmartCollar9.png

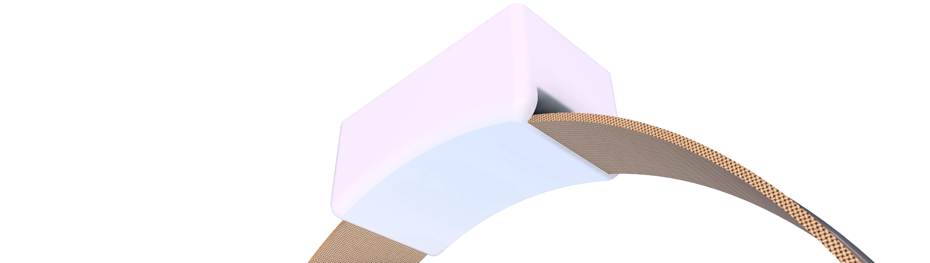
model/SmartCollar9.png
