qppd/smart-collar/model/SmartCollar10.png

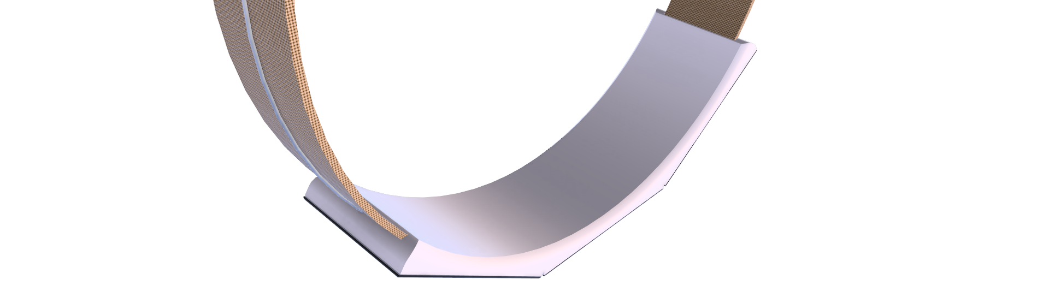
model/SmartCollar10.png
