qppd/smart-collar/(list of files, cad)

Other CAD files:
model/SmartCollar.f3z
