qppd/smart-collar/(commit log)

2026-09-08 Add STACK, FLOWCHART, BLOCK-DIAGRAM, SYSTEM-ARCHITECTURE docs
    - STACK: T-Beam/RadioLib/TinyGPSPlus/LIS3DH/AXP2101 collar stack,
    base station (DevKit+Ra-02, ESPAsyncWebServer, LittleFS),
    offline PWA (Leaflet + cached OSM), raw-LoRa radio settings
    - BLOCK-DIAGRAM: full system w/ tamper sense circuit, attack truth
    table, signal chain summary
    - FLOWCHART: collar duty-cycle state machine, base alarm pipeline,
    app session, geofence push-down path
    - SYSTEM-ARCHITECTURE: 5 layers, responsibilities, interfaces I1-I9,
    star topology, latched-alarm failure modes, phase 1->2 path
    - README: ASCII architecture replaced w/ Mermaid; tree + docs index
    updated
    All 10 mermaid blocks validated with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
2026-09-08 Switch accelerometer from LIS3DH to MPU6050
    - Address 0x68 (AD0 low), GY-521 module, INT pin (not INT1)
    - Firmware: Adafruit_MPU6050, motion detect via MOT_THR/MOT_DUR
    registers, accel-only cycle mode (PWR_MGMT_1, LP_WAKE_CTRL)
    - POWER: sleep draw ~10-70 uA; GY-521 module caution - strip PWR
    LED + bypass LDO or sleep budget dominated by 2-3 mA
    - HARDWARE/STACK/BOM/README/diagrams/references updated repo-wide
2026-09-08 Fix T-Beam v2.x pin conflicts: hall GPIO34→13, loop drive GPIO4→25, radio SX1276→SX1278 (433 MHz)
    Verified against LilyGO utilities.h, Meshtastic tbeam variant, and the
    T-Beam V1.2 schematic (header word-coordinate extraction):
    - GPIO34 = GPS NMEA input on all T-Beams (hall there kills GPS fixes)
    - GPIO4 = onboard active-low status LED (loop drive there keeps LED
    lit in sleep, ~2 mA leak, wrecks sleep budget)
    - SX1276 T-Beam variant is 868/915 MHz; 433 MHz plan needs SX1278
    - I2C: AXP2101 (0x34) + MPU6050 (0x68) coexist on bus 21/22 - no clash
    - Hall part fixed: A1104-class is 3.8V-min/4-25mA; spec reed (0uA) or
    DRV5032DU (1.8uA, true 3.3V) instead
    - Added verified onboard pin-bud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
2026-09-09 Phase 2 solar: 2x2cm panel array design, validated wiring, PH sourcing
    - POWER.md: parallel 6-8x 20x20mm panel array sizing (physics-based),
    CN3065 wiring rules (parallel-only, per-panel Schottky, trickle-rate
    safety, night drain, telemetry), Voc measurement added to checklist
    - ENCLOSURE.md: lid array layout (2x3/2x4 grid), T7000 junction potting,
    corrected CN3065 module size 40x20mm (was 15x15)
    - BOM.md: per-panel specs, Schottky line item, PH stock note (Circuitrocks,
    Erovoutika), TP4056 demoted to fallback
    - README.md: component table updated
2026-09-13 POWER: add worst-case 90s-fix runtime note (14.8 mA, ~10 days)
2026-09-13 BOM: add sourced Lazada PH order lists (24 items, verified 2026-09-13)
    Verified listings with ratings/sold/sellers per marketplace-sourcing criteria (4-star+, local sellers). Design flag: classic T-Beam v2.x SX1278 not on Lazada PH - Supreme (ESP32-S3) vs AliExpress paths documented.
2026-09-14 Docs: complete offline-first build guide with wiring diagram and Map Pack
    Adopt the final architecture across all docs: Bluetooth LE app link (no
    WiFi AP), MapLibre + OpenStreetMap offline map with one-time provisioning
    (MAP-PACK.md), DS3231 RTC restored, S-60-12 12V/5A PSU for the base,
    3-collar initial build budget, maintenance-mode toggle, and removal of
    Firebase/NTP/SD-card paths. Add WIRING.md documenting the Cirkit Designer
    diagram and netlist (siren relay on GPIO23) and restructure the README
    into an ordered 11-step build guide.
    Generated with Codebuff
2026-09-14 Remove DS3231: base clock syncs from the phone over BLE (TIME_SET)
    The farmer's phone already keeps accurate date/time, so the base station
    needs no RTC hardware. The app sends TIME_SET on every BLE connect; no
    alarm rule depends on wall time, and an offline reboot just flags history
    unsynced until the next connect. BOM drops the RTC row (base total
    ~P1,720; 3-collar build ~P14,170-15,670). Also fixes BOM ordering-note
    numbering, adds a clock row to STACK, wires WIRING/BASE-STATION clock
    references to the new scheme, and marks the completed wiring milestone
    in the README roadmap.
    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
2026-09-14 Wiring: define Ra-02 SX1278 to ESP32 pin map; move siren relay GPIO23 to GPIO27
    GPIO23 is VSPI MOSI on the ESP32, so it cannot also drive the relay IN1 -
    every SPI transfer would chatter the siren driver. The relay moves to
    GPIO27 and GPIO23 is reserved for the LoRa radio. Adds the full Ra-02
    wiring table (3.3 V only, VSPI 18/19/23/5, RST 14, DIO0 26, decoupling
    note) to WIRING.md and syncs FIRMWARE, BASE-STATION, BLOCK-DIAGRAM, and
    SYSTEM-ARCHITECTURE to the new pin assignment.
    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
2026-09-14 Wiring: adopt updated diagram - SX1278 drawn, siren relay moves to GPIO17
    The refreshed Cirkit diagram adds the SX1278 to the base circuit with the
    planned SPI pin map (VSPI 18/19/23/5, RST 14, DIO0 26), and the relay IN1
    lands on GPIO17 instead of GPIO27. Netlist re-extracted from the .ckt and
    verified; WIRING, FIRMWARE, BASE-STATION, BLOCK-DIAGRAM, and
    SYSTEM-ARCHITECTURE all updated to the new pin assignment.
    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
2026-09-14 Remove reed switches; tamper detection via loop physics, motion via polling
    The reed switch (buckle detection) and the service-mode hall sensor are
    gone: unbuckling separates a break-away link in the buckle and reads as
    an OPEN alarm - the loop's own physics does the sensing - and service
    mode is a plain BLE maintenance command. The MPU6050 loses its INT wire:
    the latched motion flag is polled over I2C each 10-min wake, which also
    lets the RTC timer become the only wake source. BOM drops the reed pack
    (collar total ~P6,549 Supreme / ~P4,060 classic; 3-collar build
    ~P13,900-15,400), FIRMWARE simplifies the packet flags and enum, and
    TESTING gains a CLEAR_LATCH guard scenario (S12).
    Generated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
2026-09-14 Wiring: adopt updated diagram (tamper loop drawn); document simplified loop delta, add resistor pair to BOM
    Netlist re-extracted from the new SmartCollar.ckt: base circuit matches
    docs exactly (GPIO17 relay, Ra-02 SPI map, S-60-12 PSU + buck). Collar
    gains the drawn tamper loop — recorded as a simplified stand-in (single
    series resistor, no GPIO25/GPIO36 junction) with the reference circuit
    still TAMPER/HARDWARE. Flags the stray duplicate T-Beam instance for
    cleanup. BOM adds the 10 kOhm bias + 100 Ohm far-end resistor pair.
    🤖 Generated with Codebuff
2026-09-15 Enclosure: add measured component dimensions & fit check (LilyGO CAD); fix BOM note — 150x150x70 forced by 104.1mm T-Beam PCB, not stock; add enclosure 3D model renders
2026-09-15 Untrack references/ (local-only source materials) and add .gitignore; keep files on disk
2026-09-16 Update circuit to SX1276/915MHz, add Fusion 360 model, exclude presentation
    - Switched all docs from SX1278/433MHz to SX1276/915MHz
    - Updated CirKit Designer circuit (.ckt + .png) with new wiring
    - Added SmartCollar.f3z Fusion 360 3D model
    - Updated WIRING.md netlist to match new circuit (tamper loop GPIO36)
    - Added model/ and presentation/ to .gitignore
    - Verified no stale SX1278/433MHz references remain
2026-09-16 docs: eliminate cross-file redundancies, enforce single-domain focus per file
    - HARDWARE.md: replace duplicated tamper circuit diagram + band table
    with cross-reference to TAMPER.md (canonical home)
    - FIRMWARE.md: trim tamper band definitions, power-critical rationale
    and maintenance mode details → cross-refs to TAMPER.md, POWER.md,
    BASE-STATION.md respectively
    - BASE-STATION.md: replace near-verbatim provisioning duplicate with
    cross-reference to APP.md
    - STACK.md: trim hardware section to overview + cross-references
    (BOM.md, HARDWARE.md, TAMPER.md, ENCLOSURE.md, BASE-STATION.md,
    POWER.md)
    - ENCLOSURE.md: trim solar wiring chain details → cross-ref to POWER.md
    - README.md: c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
2026-11-07 Hardware migration: Replace T-Beam v2.x with discrete ESP32 DevKit build
    - Replace integrated LilyGO T-Beam v2.x with ESP32 DevKit 38-pin + external NEO-M8N GPS + SX1276 LoRa modules
    - New power architecture: AP2112 LDO + GPIO-gated SI2301 MOSFETs for GPS/LoRa rail cutoff in deep sleep
    - Updated pin assignments for discrete build (UART2 for GPS, VSPI for LoRa, ADC1_CH0 for tamper sense)
    - Revised BOM with locally sourced PH components from Makerlab/Lazada — no AliExpress dependency
    - Added NTC compliance documentation for Philippine radio regulations
    - Preserved all original objectives, features, and functionality
    - Updated all 14 documentation files with consistent hardware references
2026-11-07 Remove AI-style sourcing disclaimer from BOM frontmatter
2026-11-07 Remove AI-style footnote blocks from BOM — convert to plain prose
2026-11-07 Add GPIO boot-strapping safety notes for rail gate pins
    GPIO15 (MTCK) requires explicit 10 kΩ external pull-up to 3.3 V — internal weak
    pull-up alone is unreliable and will cause download-mode hang on power-on. Same
    applies to GPIO13 (GPS rail gate). Updated HARDWARE.md pin table, WIRING.md power
    rail table, and MIGRATION-SUMMARY code comment to document this requirement.
2026-11-07 Restore Lazada PDP links in BOM tables alongside search terms
    Each row now has both a direct buy/search link and a text search query.
    Dead/OOS links are preserved for traceability — search terms serve as
    fallback when individual listings rotate.
2026-11-08 Swap LoRa to SX1278 433MHz Ra-02 and GPS to GY-NEO6MV2 with ceramic antenna
    - Collar + base station LoRa: SX1276 915MHz -> SX1278 433MHz (matching user-sourced listings)
    - GPS: upgrade from generic NEO-M8N u.FL breakout to GY-NEO6MV2 (u-blox NEO-M8N, ceramic 25x25mm antenna, UART TTL)
    - BOM verified listings:
    * GPS: Makerlab PH LazMall @₱699, ⭐4.6 (137), QC Project 6
    https://www.lazada.com.ph/products/gy-neo6mv2-neo-6m-ublox-neo-m8n-flight-controller-gps-module-i141829587-s24261148033.html
    * LoRa: GlobalLifestyle @₱267.01 (was ₱400.51), 97% seller, QC Project 6
    https://www.lazada.com.ph/products/pdp-i5363704346-s32079063512.html
    - Update all docs: 433MHz references throug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
2026-11-08 Update BOM: swap GPS to GY-NEO6MV2 (₱699), find available 915MHz LoRa from Green Life (₱388)
    - GPS: switched from generic NEO-M8N breakout to GY-NEO6MV2 (u-blox NEO-M8N, ceramic antenna, UART TTL)
    - LoRa: original Makerlab PH 915MHz Ra-02 is out of stock; added Green Life alternative
    * RMF96 LORA SX1276 915MHz at ₱388 (seller 96%, 40.5K sold, 7-year store)
    * URL: https://www.lazada.com.ph/products/pdp-i15680306857.html
    - All other docs unchanged: still using 915 MHz design throughout
    - Sourced collar total: ~₱2,653 (includes new GPS + LoRa prices)
